LeoKingsCoast/stm32-bluetooth-audio/img/circuit-schematic.pdf

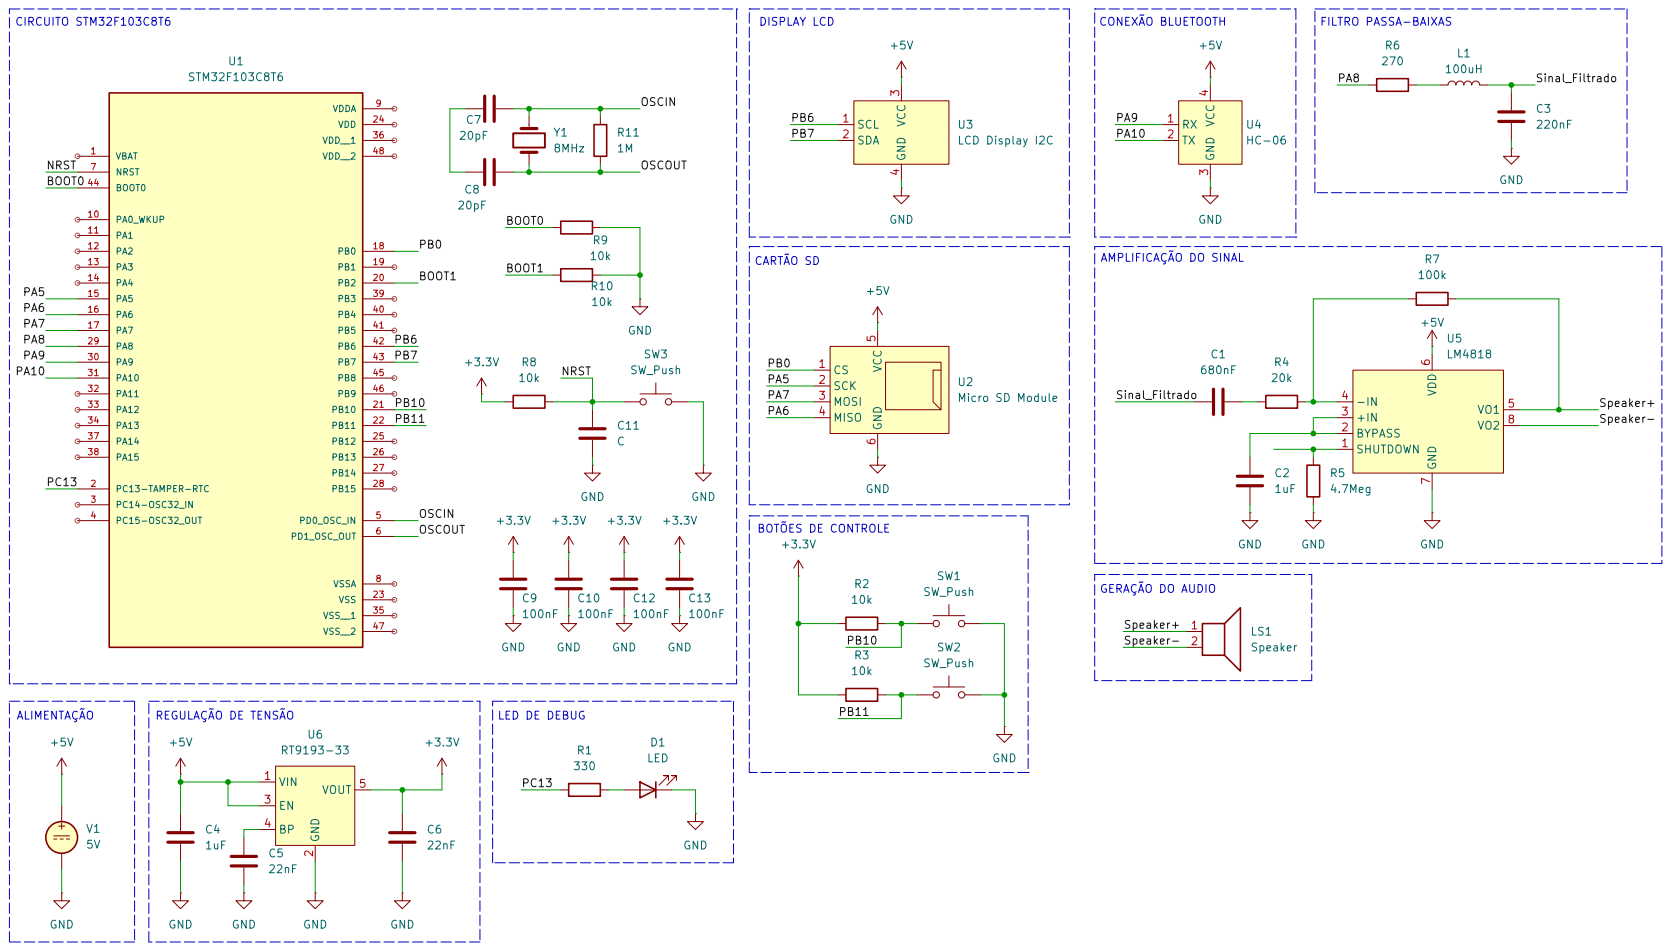
[picture p3: page 1]
