LeoKingsCoast/stm32-bluetooth-audio/Core/Src/main.c

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
/* Includes ------------------------------------------------------------------*/
#include "main.h"
#include "dma.h"
#include "fatfs.h"
#include "i2c.h"
#include "spi.h"
#include "tim.h"
#include "usart.h"
#include "gpio.h"

/* USER CODE BEGIN Includes */

#include "i2c-lcd.h"
#include "stm32f1xx_hal.h"
#include <stdint.h>
#include <string.h>
#include <stdbool.h>
#include <stdio.h>
#include "circ_buffer.h"

/* USER CODE END Includes */

/* USER CODE BEGIN PD */

#define DATA_BUFFER_SIZE        128
#define DUTY_CICLE_MULTIPLIER   ((TIM1->ARR)/256)

// Macros para delay de microsegundos, obtidas de: https://deepbluembedded.com/stm32-systick-timer-microseconds-delay-us-delay-function/
#define SYSTICK_LOAD (SystemCoreClock/1000000U)
#define SYSTICK_DELAY_CALIB (SYSTICK_LOAD >> 1)
 
#define DELAY_US(us) \
    do { \
         uint32_t start = SysTick->VAL; \
         uint32_t ticks = (us * SYSTICK_LOAD)-SYSTICK_DELAY_CALIB;  \
         while((start - SysTick->VAL) < ticks); \
    } while (0)

#define AUDIO_BUFFER_SIZE 400

/* USER CODE END PD */


/* USER CODE BEGIN PV */

FATFS FatFs; // Definição do formato de arquivo FatFs

uint8_t rx_buffer[2*DATA_BUFFER_SIZE];
uint8_t data_to_transfer[DATA_BUFFER_SIZE + 1];
bool data_ready = false;

char audio_byte;
CircBuffer audioBuffer;

uint32_t currentMillis, previousMillis;
/*uint8_t Estado;*/
enum state {
  IDLE,
  ABRE_ARQUIVO_ESCRITA,
  ESPERA_RECEPCAO,
  FECHA_ARQUIVO,
  TOCA_AUDIO,
  ERRO
} Estado;

/* USER CODE END PV */

void SystemClock_Config(void);
/* USER CODE BEGIN PFP */

// funções de controle do LCD
void lcd_string_top(char *);
void lcd_string_bottom(char *);

// funções de controle do SD Card
int SD_Mount();
void SD_Read_Size();
void SD_error_feedback(FRESULT);

// função para reprodução do áudio
void tocaAudio(FIL *file_ptr);

/* USER CODE END PFP */

/**
  * @brief  The application entry point.
  * @retval int
  */
int main(void)
{

  /* MCU Configuration--------------------------------------------------------*/

  /* Reset of all peripherals, Initializes the Flash interface and the Systick. */
  HAL_Init();

  /* Configure the system clock */
  SystemClock_Config();

  /* Initialize all configured peripherals */
  MX_GPIO_Init();
  MX_DMA_Init();
  MX_USART1_UART_Init();
  MX_I2C1_Init();
  MX_SPI1_Init();
  MX_TIM1_Init();
  MX_FATFS_Init();
  MX_USART2_UART_Init();
  /* USER CODE BEGIN 2 */

  lcd_init();
  HAL_Delay(2000);

  HAL_GPIO_WritePin(GPIOB, GPIO_PIN_5, GPIO_PIN_RESET); // pino B5 conectado ao !Enable do amplificador LM4818
  HAL_TIM_PWM_Start(&htim1, TIM_CHANNEL_1);

  lcd_clear();
  lcd_string_top("Montando SD");
  HAL_Delay(2000);

  if(SD_Mount() == 1){
    lcd_string_top("SD Mounted!");
    HAL_Delay(2000);

    //SD_Read_Size();

    Estado = IDLE;
    lcd_clear();
    lcd_string_top("IDLE");
  }
  else{
    lcd_string_top("SD Not Found    ");
    Estado = ERRO;
  }

  FIL fil; // Variável para armazenar os arquivos
  FRESULT fres; // Variável para armazenar feedback dos comandos para o cartão SD

  InitCircBuffer(&audioBuffer, AUDIO_BUFFER_SIZE);

  /* USER CODE END 2 */

  /* Infinite loop */
  /* USER CODE BEGIN WHILE */
  while (1)
  {

    switch (Estado) {
      case IDLE:
      case ERRO:
        break;

      case ESPERA_RECEPCAO:
        if(data_ready){
          // HAL_GPIO_TogglePin(GPIOC, GPIO_PIN_13); // LED 13
          f_puts((const char*)data_to_transfer, &fil);
          memset(data_to_transfer, '\0', DATA_BUFFER_SIZE + 1);
          data_ready = false;
        }
        break;

      case ABRE_ARQUIVO_ESCRITA:
        // Criando o arquivo que será usado. Se o arquivo já existe, será sobreescrito.
        fres = f_open(&fil, "Audio_teste.txt", FA_WRITE | FA_READ | FA_CREATE_ALWAYS);
        lcd_clear();
        if(fres != FR_OK){
          SD_error_feedback(fres);
          Estado = ERRO;
          break;
        }
        lcd_string_top("File open!");
        HAL_Delay(2000);

        HAL_UART_Receive_DMA(&huart1, rx_buffer, 2*DATA_BUFFER_SIZE);
        lcd_clear();
        lcd_string_top("Esperando...");
        Estado = ESPERA_RECEPCAO;
        break;

      case TOCA_AUDIO:
        // Abrindo o arquivo de áudio
        fres = f_open(&fil, "Audio_teste.txt", FA_READ);
        lcd_clear();
        if (fres != FR_OK) {
          SD_error_feedback(fres);
          Estado = ERRO;
          break;
        }
        lcd_string_top("File open!");
        HAL_Delay(2000);

        tocaAudio(&fil);

        HAL_Delay(1000);

        Estado = FECHA_ARQUIVO;
        break;

      // O estado FECHA_ARQUIVO poderia ser uma função. Mas ao escrever, achei melhor fazer um estado para 
      // melhor integrar com a interrupção do botão 11 ao fechar o arquivo após receber o áudio por bluetooth
      case FECHA_ARQUIVO:
        lcd_clear();
        lcd_string_top("Closing file...");
        HAL_Delay(2000);
        f_close(&fil);

        lcd_clear();
        lcd_string_top("IDLE");

        Estado = IDLE;
        break;
    }
    /* USER CODE END WHILE */

    /* USER CODE BEGIN 3 */
  }
  /* USER CODE END 3 */
}

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
/* USER CODE BEGIN 4 */

// ======================= Interrupções =======================

void HAL_UART_RxHalfCpltCallback(UART_HandleTypeDef *huart){
    memcpy(data_to_transfer, rx_buffer, DATA_BUFFER_SIZE);
    memset(rx_buffer, '\0', DATA_BUFFER_SIZE);
    data_ready = true;
}

void HAL_UART_RxCpltCallback(UART_HandleTypeDef *huart){
    /*UNUSED(huart);*/
    memcpy(data_to_transfer, rx_buffer + DATA_BUFFER_SIZE, DATA_BUFFER_SIZE);
    memset(rx_buffer + DATA_BUFFER_SIZE, '\0', DATA_BUFFER_SIZE);
    data_ready = true;
}

void HAL_GPIO_EXTI_Callback(uint16_t GPIO_Pin){
    currentMillis = HAL_GetTick();

    if(GPIO_Pin == GPIO_PIN_10 && (currentMillis - previousMillis > 1000)){
        if(Estado == IDLE){
            Estado = TOCA_AUDIO;
        }
    }
    else if(GPIO_Pin == GPIO_PIN_11 && (currentMillis - previousMillis > 1000)){
        if(Estado == IDLE){
            Estado = ABRE_ARQUIVO_ESCRITA;
        }
        else if (Estado == ESPERA_RECEPCAO){
            Estado = FECHA_ARQUIVO;
        }
    }

    previousMillis = currentMillis;

}

// Interrupção ativada a cada T = 45.35us quando a função tocaAudio() está em operação
void HAL_TIM_PeriodElapsedCallback(TIM_HandleTypeDef *htim){
  // Escreve o byte no registrador do duty cicle. Áudio de 22050Hz => T = 45.35us
  CircBufferPop(&audioBuffer, &audio_byte);
  TIM1->CCR1 = DUTY_CICLE_MULTIPLIER * ((uint32_t) audio_byte);
}

// ============================================================

// ============== Funções de Controle do LCD ==================

void lcd_string_top(char * str){
  lcd_put_cur(0, 0);
  lcd_send_string(str);
}

void lcd_string_bottom(char * str){
  lcd_put_cur(1, 0);
  lcd_send_string(str);
}

// ============================================================

// ============= Funções de controle do SD Card ==============
int SD_Mount(){
  FRESULT fres; // Variável para armazenar feedback dos comandos para o cartão SD

  // Montando o cartão SD
  fres = f_mount(&FatFs, "", 1);
  if(fres != FR_OK){
    return 0;
  }

  return 1;
}

void SD_Read_Size(){
    // Obtendo espaço no disco
    FATFS *pfs;
    DWORD fre_clust;
    uint32_t totalSpace, freeSpace;
    f_getfree("", &fre_clust, &pfs);
    totalSpace = (uint32_t)((pfs->n_fatent - 2) * pfs->csize * 0.5);
    freeSpace = (uint32_t)(fre_clust * pfs->csize * 0.5);

    char lcd_buff[100];

    // Escrevendo espaço no lcd
    lcd_clear();
    lcd_string_top("Total: ");
    sprintf(lcd_buff, "%lu", totalSpace);
    lcd_send_string(lcd_buff);
    lcd_string_bottom("Free: ");
    sprintf(lcd_buff, "%lu", freeSpace);
    lcd_send_string(lcd_buff);
    HAL_Delay(2000);
}

void SD_error_feedback(FRESULT fres){
  char lcd_buff[100];

  lcd_string_top("Error in file");
  lcd_string_bottom("handling.Code:");
  sprintf(lcd_buff, "%d", fres);
  lcd_send_string(lcd_buff);
}

// ============================================================
//
void tocaAudio(FIL *file_ptr){
  char byte_read;
  CircBufferReset(&audioBuffer);
  int counter = 0;

  // Enche o buffer de áudio inicialmente
  for (counter = 0; counter < AUDIO_BUFFER_SIZE; counter++) {
    f_gets(&byte_read, 2, file_ptr); // lê um byte do arquivo no SD card
    CircBufferInsert(&audioBuffer, byte_read);
  }

  DWORD file_size = f_size(file_ptr); 
  HAL_TIM_Base_Start_IT(&htim1);

  while(counter < file_size){
    if(!CircBufferIsFull(&audioBuffer)){
      f_gets(&byte_read, 2, file_ptr); // lê um byte do arquivo no SD card
      CircBufferInsert(&audioBuffer, byte_read);
      counter++;
    }
  }

  TIM1->CCR1 = 0; // Interrompe o PWM
  HAL_TIM_Base_Stop_IT(&htim1);
}

/* USER CODE END 4 */
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
