LeoKingsCoast/stm32-bluetooth-audio/Bluetooth_Audio_Player.ioc

Mcu.UserName=STM32F103C8Tx
PA10.Signal=USART1_RX
PA2.Signal=USART2_TX
PA3.Signal=USART2_RX
PA5.Signal=SPI1_SCK
PA6.Signal=SPI1_MISO
PA7.Signal=SPI1_MOSI
PA8.Signal=S_TIM1_CH1
PA9.Signal=USART1_TX
PB0.Signal=GPIO_Output
PB10.Signal=GPXTI10
PB11.Signal=GPXTI11
PB5.Signal=GPIO_Output
PB6.Signal=I2C1_SCL
PB7.Signal=I2C1_SDA
PC13-TAMPER-RTC.Signal=GPIO_Output
PD0-OSC_IN.Signal=RCC_OSC_IN
PD1-OSC_OUT.Signal=RCC_OSC_OUT
