LeoKingsCoast/stm32-bluetooth-audio/(commit log)

2024-08-20 Added circuit schematic and fixed headings
2024-08-21 Added gpio for amplifier shutdown and adjusted wait time for audio samples
2024-08-23 Changed PWM configuration for better audio
2024-09-09 Changed pwm frequency to be higher
2024-10-10 TIM interrupt working, tested with osciloscope
2024-10-18 Audio being played using interrupt and circular buffer to avoid SD Card delay
    [circ_buffer.c, circ_buffer.h, main.c]
